Ed-EE-Eng/XYscope/(commit log)

2018-01-02 PCB Gerber Files Upload
    Add PCB Gerber Files
    [X-Y Graphics Intfc(Rev_1) - Bottom Copper (Paste).gbr, X-Y Graphics Intfc(Rev_1) - Bottom Copper (Resist).gbr, X-Y Graphics Intfc(Rev_1) - Bottom Copper.gbr, X-Y Graphics Intfc(Rev_1) - Drill Data - [Through Hole].drl, X-Y Graphics Intfc(Rev_1) - Outline.gbr, X-Y Graphics Intfc(Rev_1) - Top Copper (Paste).gbr, X-Y Graphics Intfc(Rev_1) - Top Copper (Resist).gbr, X-Y Graphics Intfc(Rev_1) - Top Co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]
2018-01-03 Move Gerber Files into EXTRA folder
    Add PCB GERBER files into EXTRA folder
    [X-Y Graphics Intfc(Rev_1) - Bottom Copper (Paste).gbr, X-Y Graphics Intfc(Rev_1) - Bottom Copper (Resist).gbr, X-Y Graphics Intfc(Rev_1) - Bottom Copper.gbr, X-Y Graphics Intfc(Rev_1) - Drill Data - [Through Hole].drl, X-Y Graphics Intfc(Rev_1) - Outline.gbr, X-Y Graphics Intfc(Rev_1) - Top Copper (Paste).gbr, X-Y Graphics Intfc(Rev_1) - Top Copper (Resist).gbr, X-Y Graphics Intfc(Rev_1) - Top Co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]
2018-01-04 PCB Build Doc Update
    Update build document to cover both REV0 and REV1 artwork. Latest document also provides sofware download and library structure guidance.
2018-01-04 Update Library Structure
    Moved and updated XYscope library to conform to Arduino IDE 1.5: Library specifications ( "/src/" structure).
2018-01-04 CRT_SCOPE Example Program Update
    Updated CRT_SCOPE source code with more robust comments and fine tuning of several functions. Compiled and tested on Arduino IDE Rev 1.8.2.
